DavidBaldwin1015/WaterChanger/DatasheetsAndPinouts/ErrorDefinitions.ods

ErrorCode | Defintion
1 | Float dry with pump activated
