DavidBaldwin1015/WaterChanger/DatasheetsAndPinouts/MetadataForDBTables.ods

Sheet: DevicesMetadata
Field | Type | Comments
Device | String | Name of the device
DeviceType | String | Type of device
Active | Bool | is the device in the system
IO | Char | Input or Output
Status | Bool | On or off
Pin | Int | Pin on the Arduino, AKA connection number
AD | Char | Analog or Digital

Sheet: Errors
Field | Type | Comments
ErrorNum | Self-Inc. Int | A unique identifier
ErrorType | Int | The identifier for the type of error
ErrorExp | String | An explanation of the error
ErrorSrc | String | Where did the error occur?
Time | Timestamp | When
Resolved | Bool | Fixed or not
ResolvedTime | Timestamp | When was it fixed

Sheet: Pins
Field | type | Comments
Pin | Int | Which pin is it
used | Bool | is it in use
PinType | Char | Is it analog or digital
