DavidBaldwin1015/WaterChanger/Code/RPi/Web/double-wrench-outline.png

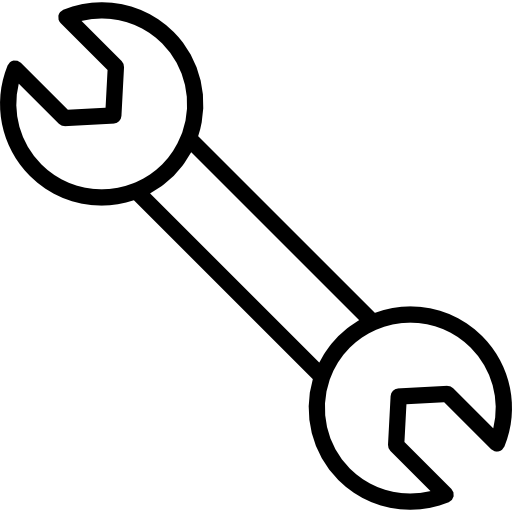
Code/RPi/Web/double-wrench-outline.png
