DavidBaldwin1015/WaterChanger/Code/RPi/Web/valve.png

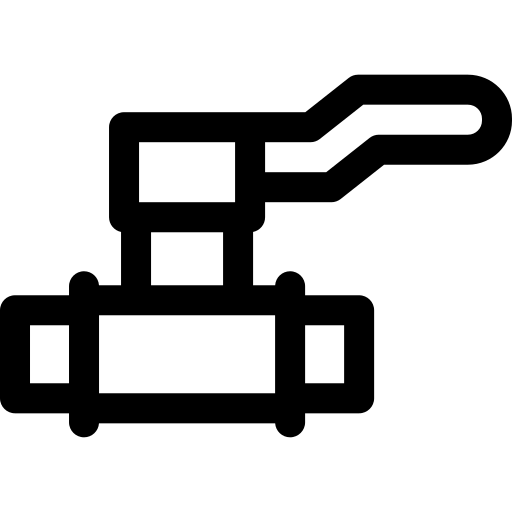
Code/RPi/Web/valve.png
