DavidBaldwin1015/WaterChanger/Code/RPi/Web/water-pump.png

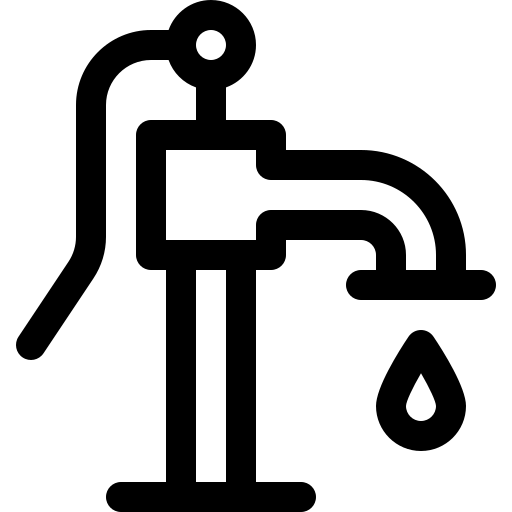
Code/RPi/Web/water-pump.png
