DavidBaldwin1015/WaterChanger/BOMs/WaterChangeBOM.ods

Sheet: One Time
Item | Qty | Price per | Total price | Link
Arduino Mega 2560 | 1 | $38.95 | $38.95 | https://www.sparkfun.com/products/11061
Raspberry Pi 3B+ | 1 | $35.00 | $35.00 | https://www.sparkfun.com/products/14643
12v Submersible water pump | 2 | $9.20 | $18.40 | https://www.digikey.com/en/products/detail/dfrobot/FIT0563/8827828
Main automated shutoff valve | 3 | $6.95 | $20.85 | https://www.adafruit.com/product/997
Main manual valve | 3 | $2.30 | $6.90 | Home Depot
Outflow meters | 3 |  | $0.00
Ultrasound depth sensors | 4 | $3.95 | $15.80 | https://www.sparkfun.com/products/15569
Float sensors | 2 |  | $0.00
inflow meters | 4 |  | $0.00
PVC SxFPT adapter for valves | 4 | $0.91 | $3.64
Raspberry Pi touchscreen display | 1 | $60.00 | $60.00 | https://www.sparkfun.com/products/13733
Relays | 5 |  | $0.00
 |  |  | $0.00
 |  |  | $0.00
 |  |  | $0.00
 |  |  | $0.00
 |  |  | $0.00
 |  |  | $0.00
 |  |  | $0.00
 |  |  | $0.00
 |  |  | $0.00
 |  |  | $0.00
 |  |  | $0.00
 |  |  | $0.00
 |  |  | $0.00
 |  |  | $0.00
 |  |  | $0.00
 |  |  | $0.00
 |  |  | $0.00
 |  |  | $199.54

Sheet: Per tank
Item | Qty | Price per | Total cost | Link
Inflow valve | 1
PVC SxFPT adapter for valves | 1
Relay 5v actuated, >=12v switching | 1
