DavidBaldwin1015/WaterChanger/BOMs/WaterChangeBOMGravityFed.ods

Sheet: One-time
Item | Qty | Price per | Total price | Link | Vendor
Arduino Mega 2560 | 1 | $38.95 | $38.95 | https://www.sparkfun.com/products/11061 | Sparkfun
Raspberry Pi 3B+ | 1 | $35.00 | $35.00 | https://www.sparkfun.com/products/14643 | Sparkfun
12v Submersible water pump | 2 | $9.20 | $18.40 | https://www.digikey.com/en/products/detail/dfrobot/FIT0563/8827828 | Digikey
Main automated shutoff valve | 3 | $24.95 | $74.85 | https://www.adafruit.com/product/996 | Adafruit
Main manual valve | 3 | $2.30 | $6.90 | Home Depot | Home Depot
Outflow meters | 3 | $9.95 | $29.85 | https://www.adafruit.com/product/828 | Adafruit
Float sensors | 2 | $7.29 | $14.58 | https://www.digikey.com/en/products/detail/littelfuse-inc/59630-4-T-02-F/4780327 | Digikey
Ultrasonic level sensors | 2 | $3.95 | $7.90 | https://www.sparkfun.com/products/15569 | Sparkfun
PVC to male brass adapter | 3 | $5.44 | $16.32 | https://www.grainger.com/product/GRAINGER-APPROVED-CPVC-to-Brass-Adapter-23NY84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 | Grainger
Raspberry Pi touchscreen display | 1 | $60.00 | $60.00 | https://www.sparkfun.com/products/13733 | Sparkfun
Relays | 5 | $3.03 | $15.15 | https://www.digikey.com/en/products/detail/toshiba-semiconductor-and-storage/TLP3542-F/871299 | Digikey
Power supply | 1 | $24.95 | $24.95 | https://www.adafruit.com/product/352 | Adafruit
2.1 mm DC Power plug | 1 | $0.95 | $0.95 | https://www.adafruit.com/product/373 | Adafruit
Power supply cable splitter | 1 | $2.95 | $2.95 | https://www.adafruit.com/product/1351 | Adafruit
Voltage converter | 1 | $9.95 | $9.95 | https://www.adafruit.com/product/1385 | Adafruit
PVC to female brass adapter | 9 | $5.67 | $51.03 | https://www.grainger.com/product/GRAINGER-APPROVED-CPVC-to-Brass-Adapter-23NY81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 | Grainger
 |  |  | $0.00
 |  |  | $0.00
 |  |  | $0.00
 |  |  | $0.00
 |  |  | $0.00
 |  |  | $0.00
 |  |  | $0.00
 |  |  | $0.00
 |  |  | $0.00
 |  |  | $0.00
 |  |  | $0.00
 |  |  | $0.00
 |  |  | $407.73

Sheet: Per-tank
Item | Qty | Price per | Total cost | Link | Vendor
Inflow valve | 1 | $24.95 | $24.95 | https://www.adafruit.com/product/996 | Adafruit
PVC to female brass adapter | 2 | $5.67 | $11.34 | https://www.grainger.com/product/GRAINGER-APPROVED-CPVC-to-Brass-Adapter-23NY81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 | Grainger
Relay 5v actuated, >=12v switching | 1 | $3.03 | $3.03 | https://www.digikey.com/en/products/detail/toshiba-semiconductor-and-storage/TLP3542-F/871299 | Digikey
 |  |  | $0.00
 |  |  | $0.00
 |  |  | $0.00
 |  |  | $0.00
 |  |  | $0.00
 |  |  | $0.00
 |  |  | $0.00
 |  |  | $0.00
 |  |  | $0.00
 |  |  | $0.00
 |  |  | $0.00
 |  |  | $0.00
 |  |  | $0.00
 |  |  | $0.00
 |  |  | $0.00
 |  |  | $0.00
 |  |  | $0.00
 |  |  | $0.00
 |  |  | $0.00
 |  |  | $0.00
 |  |  | $0.00
 |  |  | $0.00
 |  |  | $0.00
 |  |  | $0.00
 |  |  | $39.32
