DavidBaldwin1015/WaterChanger/BOMs/WaterChangeBOMwithoutGravity.ods

Sheet: One Time
Item | Qty | Price per | Total price | Link | Vendor
Arduino Mega 2560 | 1 | $38.95 | $38.95 | https://www.sparkfun.com/products/11061 | Sparkfun
Raspberry Pi 3B+ | 1 | $35.00 | $35.00 | https://www.sparkfun.com/products/14643 | Sparkfun
12v Submersible water pump | 2 | $9.20 | $18.40 | https://www.digikey.com/en/products/detail/dfrobot/FIT0563/8827828 | Digikey
Main automated shutoff valve | 3 | $6.95 | $20.85 | https://www.adafruit.com/product/997 | Adafruit
Main manual valve | 3 | $2.30 | $6.90 | Home Depot | Home Depot
Outflow meters | 3 | $9.95 | $29.85 | https://www.adafruit.com/product/828 | Adafruit
Float sensors | 2 | $7.29 | $14.58 | https://www.digikey.com/en/products/detail/littelfuse-inc/59630-4-T-02-F/4780327 | Digikey
inflow meters | 6 | $9.95 | $59.70 | https://www.adafruit.com/product/828 | Adafruit
PVC SxFPT adapter for valves and meters | 26 | $0.91 | $23.66 | Home Depot | Home Depot
Raspberry Pi touchscreen display | 1 | $60.00 | $60.00 | https://www.sparkfun.com/products/13733 | Sparkfun
Photorelay | 5 | $3.03 | $15.15 | https://www.digikey.com/en/products/detail/toshiba-semiconductor-and-storage/TLP3542-F/871299 | Digikey
Power supply | 1 | $24.95 | $24.95 | https://www.adafruit.com/product/352 | Adafruit
2.1 mm DC Power plug | 1 | $0.95 | $0.95 | https://www.adafruit.com/product/373 | Adafruit
Power supply cable splitter | 1 | $2.95 | $2.95 | https://www.adafruit.com/product/1351 | Adafruit
Voltage converter | 1 | $9.95 | $9.95 | https://www.adafruit.com/product/1385 | Adafruit
2 position JST board connectors | 75 | $0.16 | $12.00 | https://www.digikey.com/en/products/detail/jst-sales-america-inc/S2B-PH-K-S(LF)(SN)/926626 | Digikey
2 postion JST cable endings | 75 | $0.29 | $21.89 | https://www.digikey.com/en/products/detail/jst-sales-america-inc/02KR-D6S-P/2797501 | Digikey
3 position JST board connectors | 10 | $0.17 | $1.69 | https://www.digikey.com/en/products/detail/jst-sales-america-inc/S3B-PH-K-S-LF-SN/926627 | Digikey
3 pin JST cable connectors | 10 | $0.32 | $3.19 | https://www.digikey.com/en/products/detail/jst-sales-america-inc/03KR-6H-P/2797474 | Digikey
26 GA red wire x 100’ | 1 | $12.97 | $12.97 | https://www.digikey.com/en/products/detail/remington-industries/26UL1007SLDRED/11613857 | Digikey
26 GA black wire x 100’ | 1 | $12.97 | $12.97 | https://www.digikey.com/en/products/detail/remington-industries/26UL1007SLDBLA/11615378 | Digikey
26 GA yellow wire x 100’ | 1 | $12.97 | $12.97 | https://www.digikey.com/en/products/detail/remington-industries/26UL1007SLDYEL25/11614587 | Digikey
USB-B to USB-A cable | 1 | $2.95 | $2.95 | https://www.adafruit.com/product/900 | Adafruit
 |  |  | $0.00
 |  |  | $0.00
 |  |  | $0.00
 |  |  | $0.00
 |  |  | $0.00
 |  |  | $442.47

Sheet: Per tank
Item | Qty | Price per | Total cost | Link | Vendor
Inflow valve | 1 | $6.95 | $6.95 | https://www.adafruit.com/product/997 | Adafruit
PVC SxFPT adapter for valves | 2 | $0.91 | $1.82 | Home Depot | Home Depot
Photorelay | 1 | $3.03 | $3.03 | https://www.digikey.com/en/products/detail/toshiba-semiconductor-and-storage/TLP3542-F/871299 | Digikey
 |  |  | $0.00
 |  |  | $0.00
 |  |  | $0.00
 |  |  | $0.00
 |  |  | $0.00
 |  |  | $0.00
 |  |  | $0.00
 |  |  | $0.00
 |  |  | $0.00
 |  |  | $0.00
 |  |  | $0.00
 |  |  | $0.00
 |  |  | $0.00
 |  |  | $0.00
 |  |  | $0.00
 |  |  | $0.00
 |  |  | $0.00
 |  |  | $0.00
 |  |  | $0.00
 |  |  | $0.00
 |  |  | $0.00
 |  |  | $0.00
 |  |  | $0.00
 |  |  | $0.00
 |  |  | $11.80
