DavidBaldwin1015/WaterChanger/DatasheetsAndPinouts/Pins.ods

Sheet: Digital
ARDUINOPIN | IO | CONNECTION | PORT | PIN | DDRVAL | PORTVAL
D00 | NC | RX | E | 0 | 0
D15 | INPUT | OUTFLOW1 | J | 0 | 0
D17 | INPUT | OUTFLOW3 | H | 0 | 0
D21 | OUTPUT | TANK 12 | D | 0 | 1
D22 | OUTPUT | TANK 13 | A | 0 | 1
D37 | OUTPUT | TANK 28 | C | 0 | 1
D41 | OUTPUT | TANK 32 | G | 0 | 1
D49 | OUTPUT | TANK 40 | L | 0 | 1
D53 | OUTPUT | TANK 44 | B | 0 | 1
D01 | NC | TX | E | 1 | 0
D14 | INPUT | INFLOW6 | J | 1 | 0
D16 | INPUT | OUTFLOW2 | H | 1 | 0
D20 | OUTPUT | TANK 11 | D | 1 | 1
D23 | OUTPUT | TANK 14 | A | 1 | 1
D36 | OUTPUT | TANK 27 | C | 1 | 1
D40 | OUTPUT | TANK 31 | G | 1 | 1
D48 | OUTPUT | TANK 39 | L | 1 | 1
D52 | OUTPUT | TANK 43 | B | 1 | 1
D19 | OUTPUT | TANK 10 | D | 2 | 1
D24 | OUTPUT | TANK 15 | A | 2 | 1
D35 | OUTPUT | TANK 26 | C | 2 | 1
D39 | OUTPUT | TANK 30 | G | 2 | 1
D47 | OUTPUT | TANK 38 | L | 2 | 1
D51 | OUTPUT | TANK 42 | B | 2 | 1
D05 | OUTPUT | MAIN VALVE 2 | E | 3 | 1
D06 | OUTPUT | MAIN VALVE 3 | H | 3 | 1
D18 | OUTPUT | TANK 9 | D | 3 | 1
D25 | OUTPUT | TANK 16 | A | 3 | 1
D34 | OUTPUT | TANK 25 | C | 3 | 1
D46 | OUTPUT | TANK 37 | L | 3 | 1
D50 | OUTPUT | TANK 41 | B | 3 | 1
D02 | OUTPUT | PUMP 1 | E | 4 | 1
D07 | INPUT | INFLOW2 | H | 4 | 0
D10 | INPUT | FLOAT 1 | B | 4 | 0
D26 | OUTPUT | TANK 17 | A | 4 | 1
D33 | OUTPUT | TANK 24 | C | 4 | 1
D45 | OUTPUT | TANK 36 | L | 4 | 1
D03 | OUTPUT | PUMP 2 | E | 5 | 1
D04 | OUTPUT | MAIN VALVE 1 | G | 5 | 1
D08 | INPUT | INFLOW3 | H | 5 | 0
D11 | INPUT | FLOAT 2 | B | 5 | 0
D27 | OUTPUT | TANK 18 | A | 5 | 1
D32 | OUTPUT | TANK 23 | C | 5 | 1
D44 | OUTPUT | TANK 35 | L | 5 | 1
D09 | INPUT | INFLOW1 | H | 6 | 0
D12 | INPUT | INFLOW4 | B | 6 | 0
D28 | OUTPUT | TANK 19 | A | 6 | 1
D31 | OUTPUT | TANK 22 | C | 6 | 1
D43 | OUTPUT | TANK 34 | L | 6 | 1
D13 | INPUT | INFLOW5 | B | 7 | 0
D29 | OUTPUT | TANK 20 | A | 7 | 1
D30 | OUTPUT | TANK 21 | C | 7 | 1
D38 | OUTPUT | TANK 29 | D | 7 | 1
D42 | OUTPUT | TANK 33 | L | 7 | 1

Sheet: Analog
Pin | IO | Connection
A0
A1
A2
A3
A4
A5
A6
A7
A8
A9
A10
A11
A12
A13
A14
A15
