DavidBaldwin1015/WaterChanger/BOMs/BOMPart2.ods

Item | Qty | Price per | Total price | Link
12 Position Header | 1 | $0.78 | $0.78 | https://www.digikey.com/en/products/detail/PPTC121LFBN-RC/S6100-ND/807231?itemSeq=366412512
15 position header | 1 | $1.68 | $1.68 | https://www.digikey.com/en/products/detail/929974-01-15-RK/929974E-01-15-ND/1094268?itemSeq=366413524
16 position header | 1 | $1.80 | $1.80 | https://www.digikey.com/en/products/detail/929974-01-16-RK/929974E-01-16-ND/1094269?itemSeq=366413544
25 position header | 1 | $2.60 | $2.60 | https://www.digikey.com/en/products/detail/929974-01-25-RK/929974E-01-25-ND/1094278?itemSeq=366413562
3 position header | 25 | $0.37 | $9.36 | https://www.digikey.com/en/products/detail/929974-01-03-RK/929974E-01-03-ND/1094256?itemSeq=366413669
TLP3542 photorelays | 35 | $2.52 | $88.37 | https://www.digikey.com/en/products/detail/TLP3542(F)/TLP3542F-ND/871299?itemSeq=366413753
2x2 header pins | 1 | $0.88 | $0.88 | https://www.digikey.com/en/products/detail/929665-01-02-I/3M156307-04-ND/2183891?itemSeq=366673051
 |  |  | $0.00
 |  |  | $0.00
 |  |  | $105.47
