DavidBaldwin1015/WaterChanger/DesignPDFs/WaterChangeCircuits.pdf

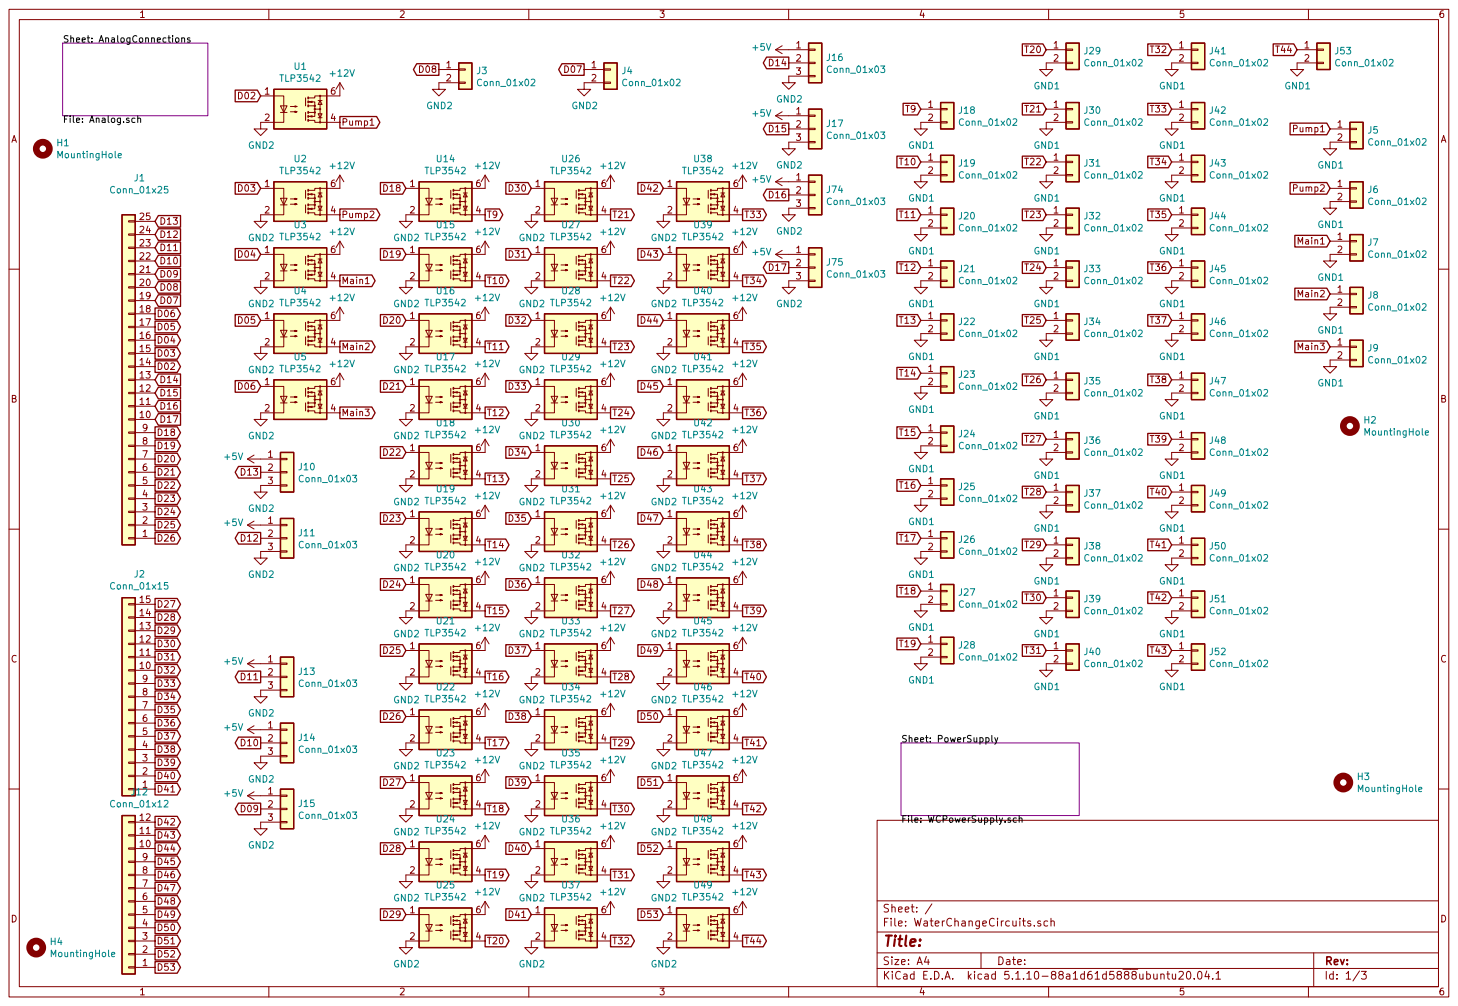
[picture p4: page 1]

File: WaterChangeCircuits.sch Sheet: /
Id: 1/3 Title:

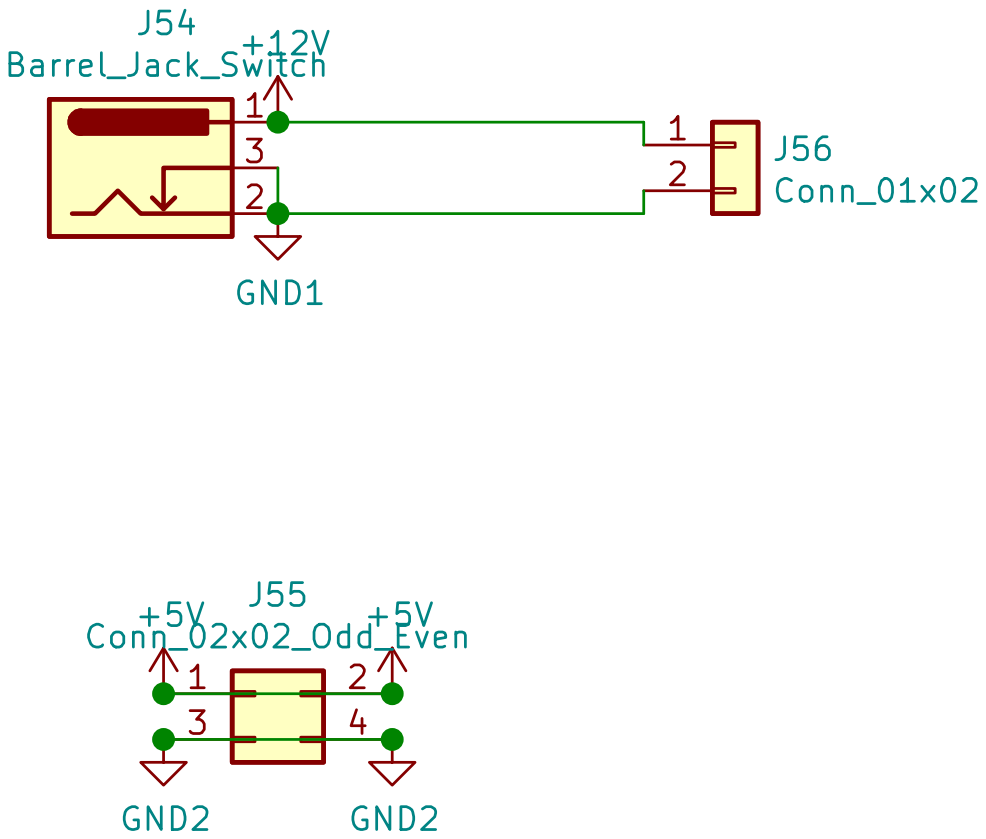
[picture p5: page 2]

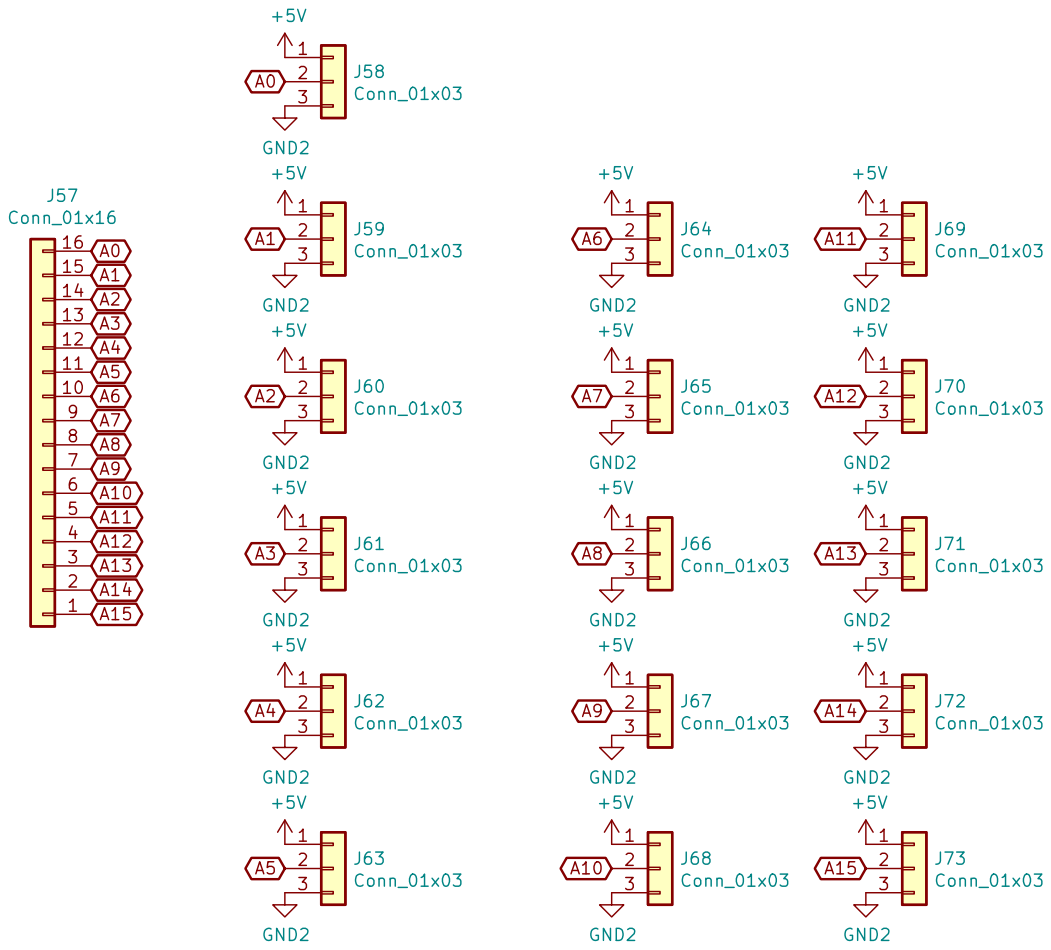
[picture p6: page 3]
