DavidBaldwin1015/WaterChanger/DesignPDFs/Complete.pdf

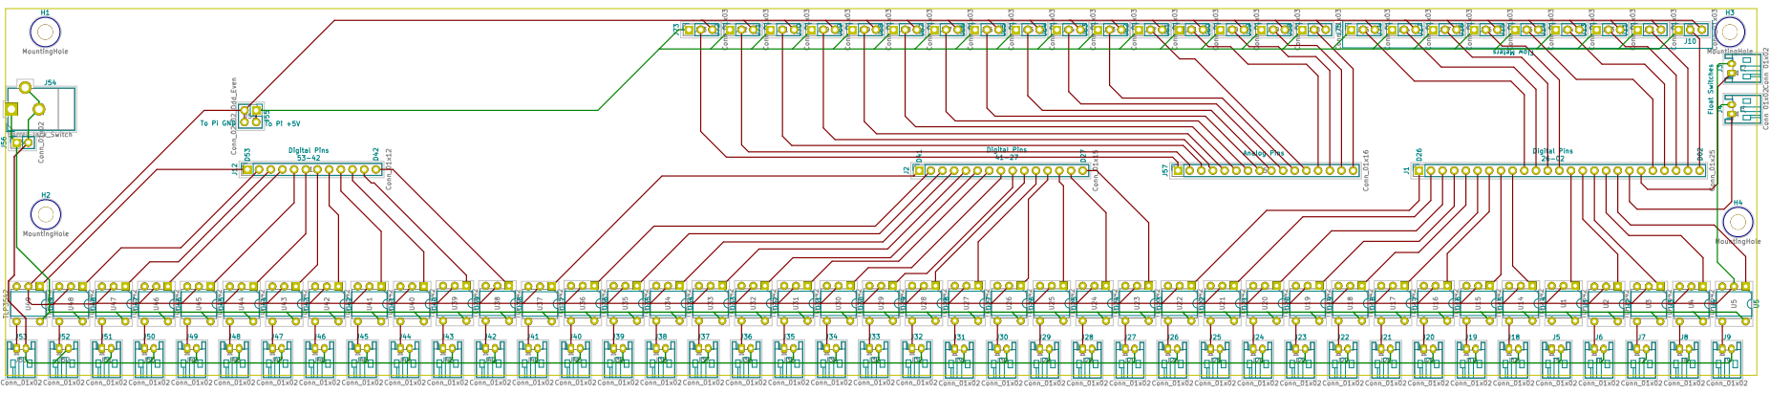
[picture p7: page 1]
