DavidBaldwin1015/WaterChanger/KiCADProjects/WaterChangeCircuits/WaterChangeCircuits.kicad_pcb

## KiCad design KiCADProjects/WaterChangeCircuits/WaterChangeCircuits.kicad_pcb (2021-06-02)

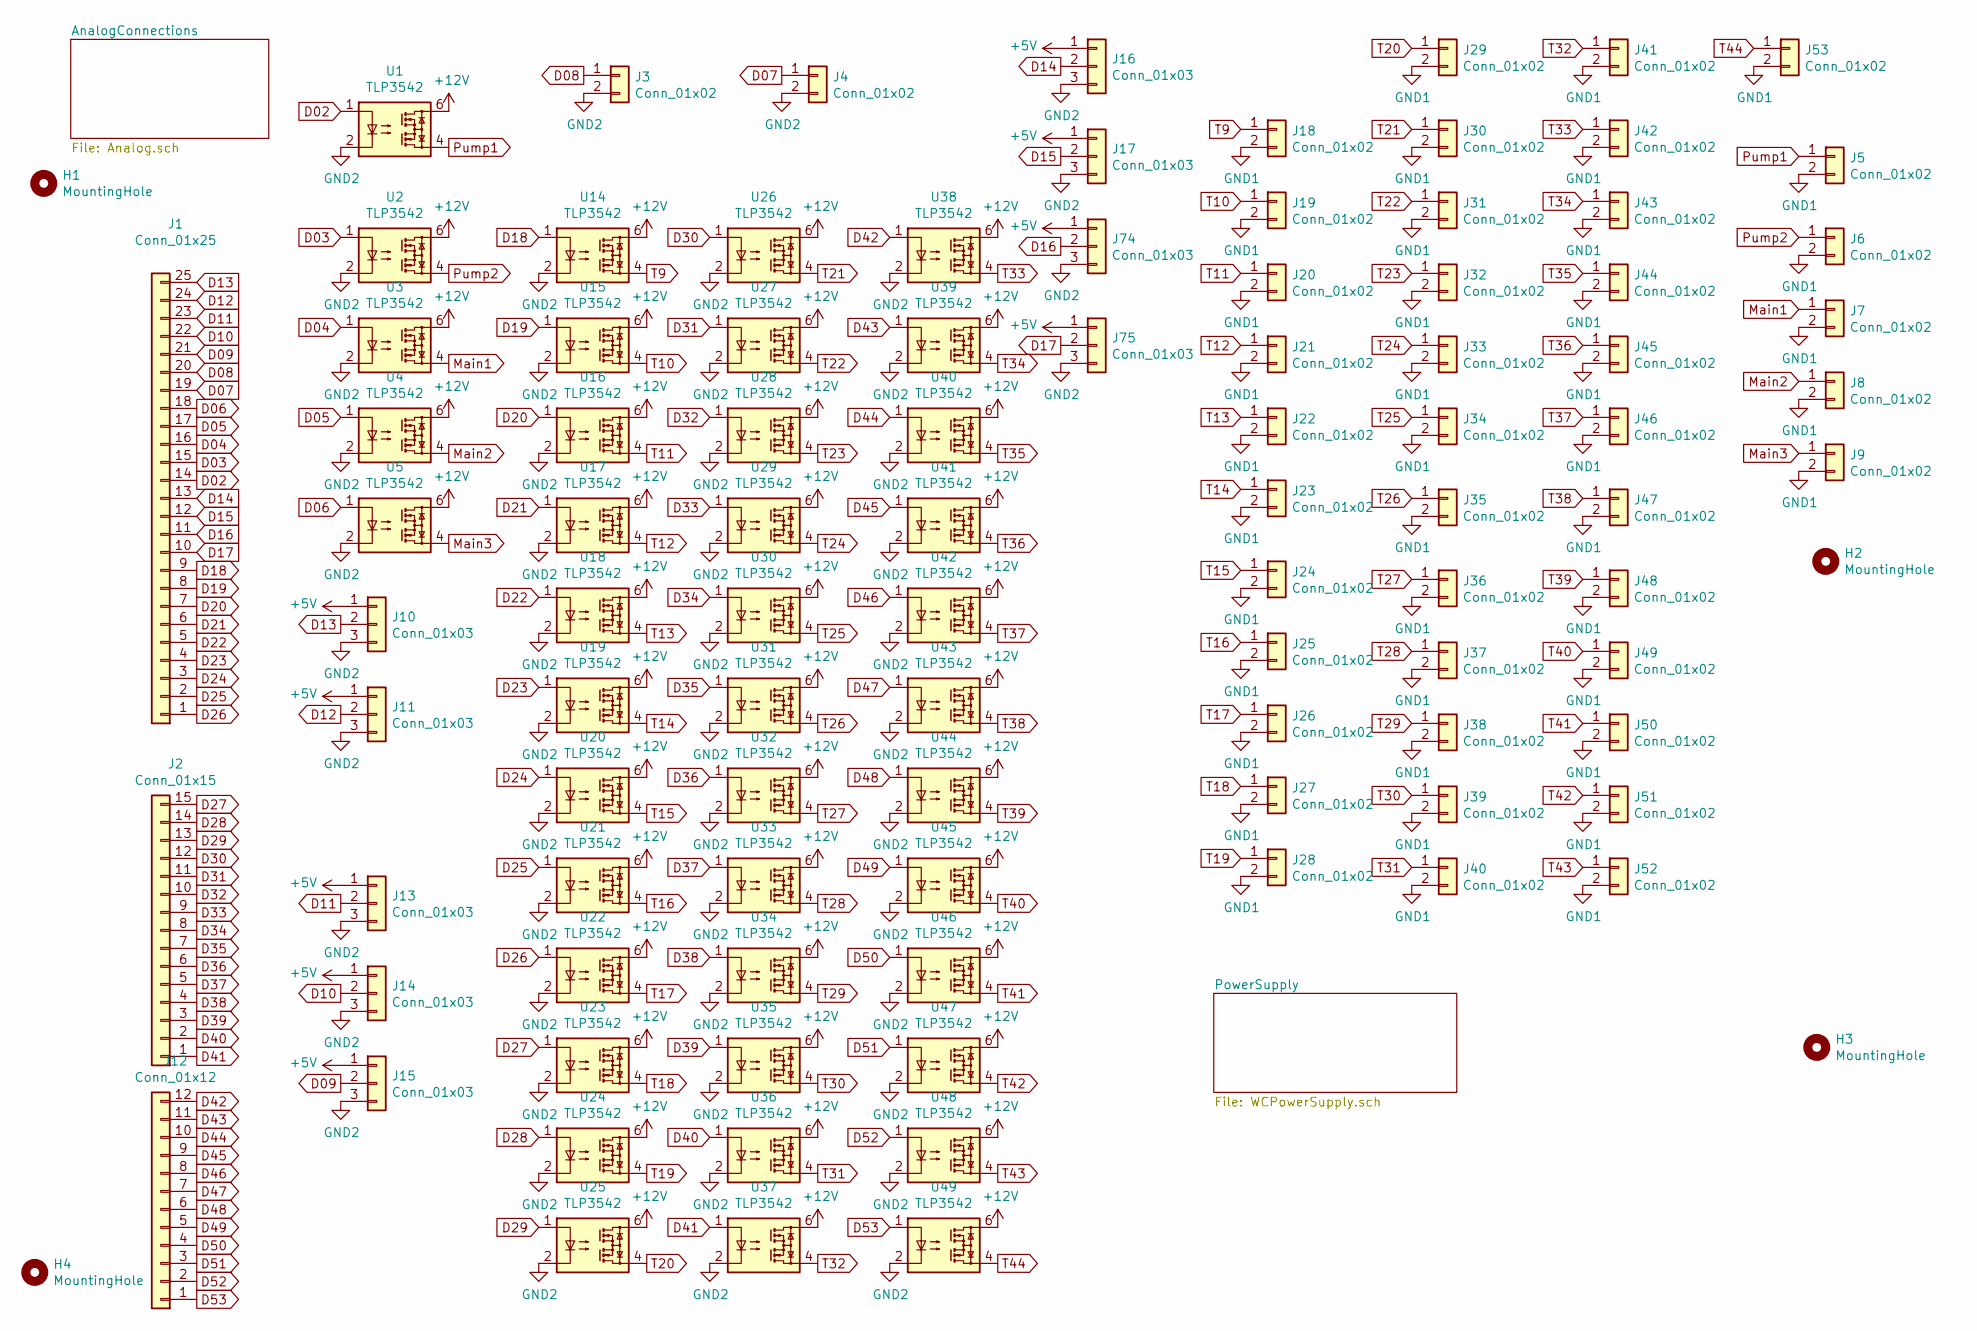
[picture p8: schematic WaterChangeCircuits.sch]

Parts:
H1, H2, H3, H4: MountingHole; MountingHole_3.2mm_M3
J1: Conn_01x25; PinSocket_1x25_P2.54mm_Vertical
J2: Conn_01x15; PinSocket_1x15_P2.54mm_Vertical
J3, J4, J5, J6, J7, J8, J9, J18, J19, J20, J21, J22, J23, J24, J25, J26, J27, J28, J29, J30, J31, J32, J33, J34, J35, J36, J37, J38, J39, J40, J41, J42, J43, J44, J45, J46, J47, J48, J49, J50, J51, J52, J53: Conn_01x02; JST_PH_S2B-PH-K_1x02_P2.00mm_Horizontal
J10, J11, J13, J14, J15, J16, J17, J74, J75: Conn_01x03; PinSocket_1x03_P2.54mm_Vertical
J12: Conn_01x12; PinSocket_1x12_P2.54mm_Vertical
U1, U2, U3, U4, U5, U14, U15, U16, U17, U18, U19, U20, U21, U22, U23, U24, U25, U26, U27, U28, U29, U30, U31, U32, U33, U34, U35, U36, U37, U38, U39, U40, U41, U42, U43, U44, U45, U46, U47, U48, U49: TLP3542; DIP-5-6_W7.62mm

Connections:
+5V: J10.1, J11.1, J13.1, J14.1, J15.1, J16.1, J17.1, J74.1, J75.1; also elsewhere on the board
+12V: U1.6, U2.6, U3.6, U4.6, U5.6, U14.6, U15.6, U16.6, U17.6, U18.6, U19.6, U20.6, U21.6, U22.6, U23.6, U24.6, U25.6, U26.6, U27.6, U28.6, U29.6, U30.6, U31.6, U32.6, U33.6, U34.6, U35.6, U36.6, U37.6, U38.6, U39.6, U40.6, U41.6, U42.6, U43.6, U44.6, U45.6, U46.6, U47.6, U48.6, U49.6; also elsewhere on the board
D02: J1.14, U1.1
D03: J1.15, U2.1
D04: J1.16, U3.1
D05: J1.17, U4.1
D06: J1.18, U5.1
D07: J1.19, J4.1
D08: J1.20, J3.1
D09: J1.21, J15.2
D10: J1.22, J14.2
D11: J1.23, J13.2
D12: J1.24, J11.2
D13: J1.25, J10.2
D14: J1.13, J16.2
D15: J1.12, J17.2
D16: J1.11, J74.2
D17: J1.10, J75.2
D18: J1.9, U14.1
D19: J1.8, U15.1
D20: J1.7, U16.1
D21: J1.6, U17.1
D22: J1.5, U18.1
D23: J1.4, U19.1
D24: J1.3, U20.1
D25: J1.2, U21.1
D26: J1.1, U22.1
D27: J2.15, U23.1
D28: J2.14, U24.1
D29: J2.13, U25.1
D30: J2.12, U26.1
D31: J2.11, U27.1
D32: J2.10, U28.1
D33: J2.9, U29.1
D34: J2.8, U30.1
D35: J2.7, U31.1
D36: J2.6, U32.1
D37: J2.5, U33.1
D38: J2.4, U34.1
D39: J2.3, U35.1
D40: J2.2, U36.1
D41: J2.1, U37.1
D42: J12.12, U38.1
D43: J12.11, U39.1
D44: J12.10, U40.1
D45: J12.9, U41.1
D46: J12.8, U42.1
D47: J12.7, U43.1
D48: J12.6, U44.1
D49: J12.5, U45.1
D50: J12.4, U46.1
D51: J12.3, U47.1
D52: J12.2, U48.1
D53: J12.1, U49.1
GND1: J5.2, J6.2, J7.2, J8.2, J9.2, J18.2, J19.2, J20.2, J21.2, J22.2, J23.2, J24.2, J25.2, J26.2, J27.2, J28.2, J29.2, J30.2, J31.2, J32.2, J33.2, J34.2, J35.2, J36.2, J37.2, J38.2, J39.2, J40.2, J41.2, J42.2, J43.2, J44.2, J45.2, J46.2, J47.2, J48.2, J49.2, J50.2, J51.2, J52.2, J53.2; also elsewhere on the board
GND2: J3.2, J4.2, J10.3, J11.3, J13.3, J14.3, J15.3, J16.3, J17.3, J74.3, J75.3, U1.2, U2.2, U3.2, U4.2, U5.2, U14.2, U15.2, U16.2, U17.2, U18.2, U19.2, U20.2, U21.2, U22.2, U23.2, U24.2, U25.2, U26.2, U27.2, U28.2, U29.2, U30.2, U31.2, U32.2, U33.2, U34.2, U35.2, U36.2, U37.2, U38.2, U39.2, U40.2, U41.2, U42.2, U43.2, U44.2, U45.2, U46.2, U47.2, U48.2, U49.2; also elsewhere on the board
Main1: J7.1, U3.4
Main2: J8.1, U4.4
Main3: J9.1, U5.4
Pump1: J5.1, U1.4
Pump2: J6.1, U2.4
T9: J18.1, U14.4
T10: J19.1, U15.4
T11: J20.1, U16.4
T12: J21.1, U17.4
T13: J22.1, U18.4
T14: J23.1, U19.4
T15: J24.1, U20.4
T16: J25.1, U21.4
T17: J26.1, U22.4
T18: J27.1, U23.4
T19: J28.1, U24.4
T20: J29.1, U25.4
T21: J30.1, U26.4
T22: J31.1, U27.4
T23: J32.1, U28.4
T24: J33.1, U29.4
T25: J34.1, U30.4
T26: J35.1, U31.4
T27: J36.1, U32.4
T28: J37.1, U33.4
T29: J38.1, U34.4
T30: J39.1, U35.4
T31: J40.1, U36.4
T32: J41.1, U37.4
T33: J42.1, U38.4
T34: J43.1, U39.4
T35: J44.1, U40.4
T36: J45.1, U41.4
T37: J46.1, U42.4
T38: J47.1, U43.4
T39: J48.1, U44.4
T40: J49.1, U45.4
T41: J50.1, U46.4
T42: J51.1, U47.4
T43: J52.1, U48.4
T44: J53.1, U49.4

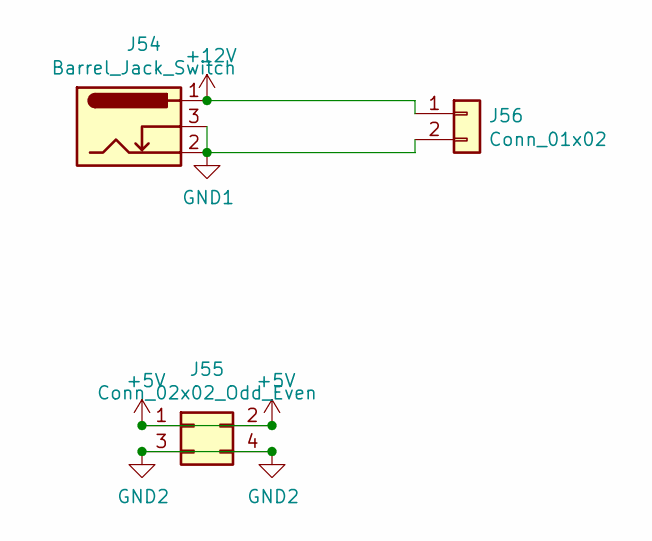
[picture p9: schematic WCPowerSupply.sch]

Parts:
J54: Barrel_Jack_Switch; BarrelJack_CUI_PJ-102AH_Horizontal
J55: Conn_02x02_Odd_Even; PinHeader_2x02_P2.54mm_Vertical
J56: Conn_01x02; PinSocket_1x02_P2.54mm_Vertical

Connections:
+5V: J55.1, J55.2; also elsewhere on the board
+12V: J54.1, J56.1; also elsewhere on the board
GND1: J54.2, J54.3, J56.2; also elsewhere on the board
GND2: J55.3, J55.4; also elsewhere on the board

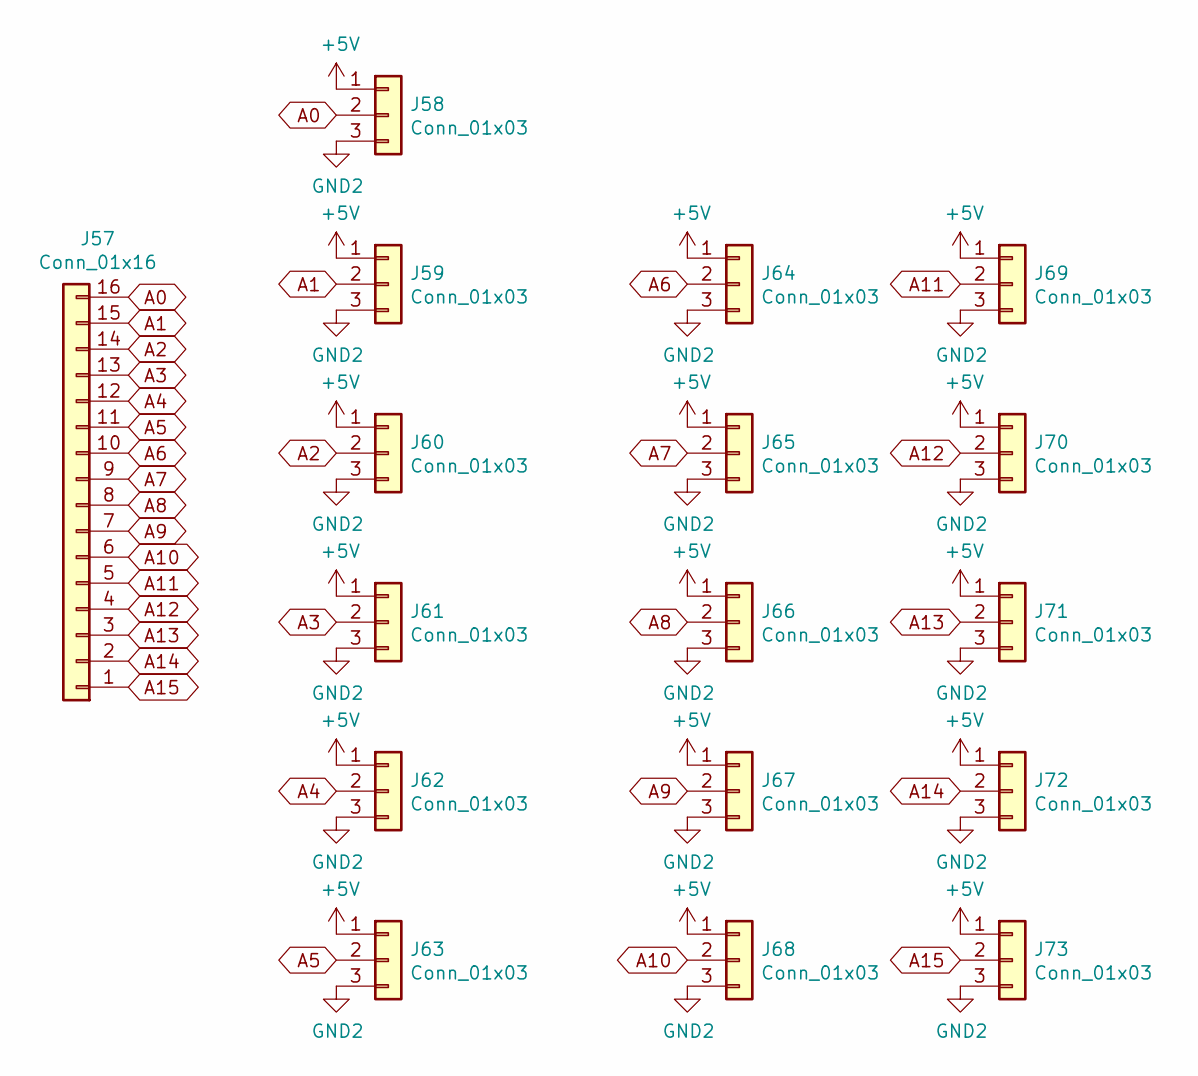
[picture p10: schematic Analog.sch]

Parts:
J57: Conn_01x16; PinSocket_1x16_P2.54mm_Vertical
J58, J59, J60, J61, J62, J63, J64, J65, J66, J67, J68, J69, J70, J71, J72, J73: Conn_01x03; PinSocket_1x03_P2.54mm_Vertical

Connections:
+5V: J58.1, J59.1, J60.1, J61.1, J62.1, J63.1, J64.1, J65.1, J66.1, J67.1, J68.1, J69.1, J70.1, J71.1, J72.1, J73.1; also elsewhere on the board
A0: J57.16, J58.2
A1: J57.15, J59.2
A2: J57.14, J60.2
A3: J57.13, J61.2
A4: J57.12, J62.2
A5: J57.11, J63.2
A6: J57.10, J64.2
A7: J57.9, J65.2
A8: J57.8, J66.2
A9: J57.7, J67.2
A10: J57.6, J68.2
A11: J57.5, J69.2
A12: J57.4, J70.2
A13: J57.3, J71.2
A14: J57.2, J72.2
A15: J57.1, J73.2
GND2: J58.3, J59.3, J60.3, J61.3, J62.3, J63.3, J64.3, J65.3, J66.3, J67.3, J68.3, J69.3, J70.3, J71.3, J72.3, J73.3; also elsewhere on the board

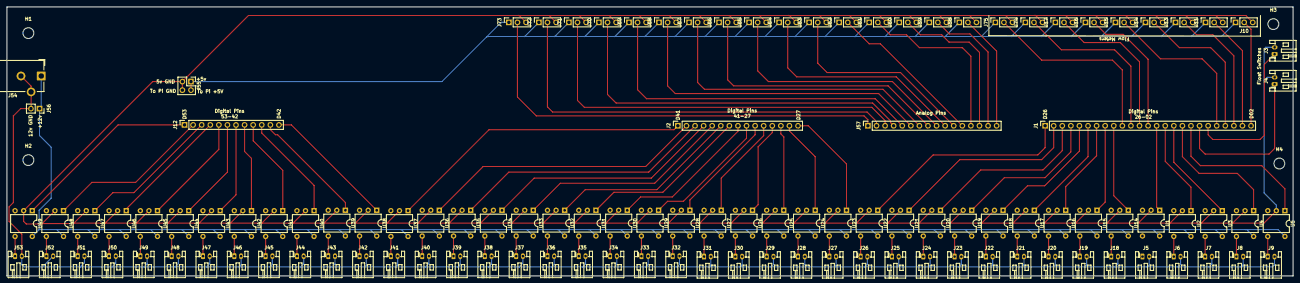
[picture p11: board WaterChangeCircuits.kicad_pcb from above]

Board: 2 copper layers, 380.7 x 79.6 mm, 120 parts (0 on the bottom side), 113 nets.
