DavidBaldwin1015/WaterChanger/(commit log)

2021-05-23 Ading all dev files
    [Analog.sch, MEGA2560_Rev3e.brd, MEGA2560_Rev3e.sch, Pins.ods, WCPowerSupply.sch, WaterChangeBOM.ods, WaterChangeBOMGravityFed.ods, WaterChangeBOMwithoutGravity.ods]
2021-05-24 Updated circuits, added code from Adafruit for the flow meter, added some more commands to the main file
2021-05-24 Cleaned up some files that were in the wrong place, or no longer needed
    [FlowMeterTest.cpp]
2021-05-25 Changed the circuit design to make the inputs from the flowmeters digital, started the webform designs for the RPi
    [MetadataForDBTables.ods, Pins.ods, WaterChangeCircuits.sch]
2021-05-26 Completed PCB design and schematics.
    [Analog.sch, WCPowerSupply.sch, WaterChangeCircuits.kicad_pcb, WaterChangeCircuits.sch]
2021-05-26 Added PDF of the PCB layout
2021-05-26 Added PDF of the schematic
    [WaterChangeCircuits.kicad_pcb, WaterChangeCircuits.sch]
2021-06-02 Updated some design files and added parts of the web app
    [BOMPart2.ods, BOMPart2.xlsx, MetadataForDBTables.ods, WaterChangeCircuits.csv, WaterChangeCircuits.kicad_pcb]
2021-06-02 fixed the php script for adding devices
2021-06-03 Added on to the web app, fixed the add device form, added styling
2021-06-03 Attempting to fix the error in adding a device
2021-06-04 Added a query to the new device script, added a csv file of all the pins for the DB
    [Pins.csv]
2021-06-04 Fixed some issues with the New Device script
2021-06-05 Completed the pump control page, added a lot of functions to the arduino code, added error alert code to the dashboard.
    [ErrorDefinitions.ods, MetadataForDBTables.ods]
2021-06-05 Added commands to close php to mysql connections
    [ErrorDefinitions.ods, Pins.ods]
2021-06-05 Added a python script for passing serial commands to Arduino
2021-06-06 Attempt to fix an error
    [SerialControl.py]
2021-06-07 Fixed the rror in the python serial control script
    [SerialControl.py, WaterChangeControl.cpp]
2021-06-07 finally fixed the python serial script, apparently the Arduino was resetting whenever a serial connection was made
    [SerialControl.py]
2021-06-07 Fixed an error where commands were repeated
    [SerialControl.py, WaterChangeControl.cpp]
2021-06-07 Added some commands for the pumps, updated the logic in the Arduino firmware
2021-06-07 Fixed some PHP errors
    [SerialControl.py, WaterChangeControl.cpp]
2021-06-08 Started adding a flowmeter function and functions for digital pin reads
